TobiasWulf/LED_Cube/README.md

# LED_Cube
Full completed hardware and software project wich I did for EESTEC during my studies at HAW
