TobiasWulf/LED_Cube/Project Outputs for LED_CUBE_5x5x5/Cube_Connector/ReadMe.txt

Hallo Bilex Team,

im RAR-Archiv findet ihr die Gerber files mit der einzelnen Layer.

*.gtl - top-layer
*.gbl - bottom-layer
*.gts - top solder
*.gbs - bottom solder
*.gm1 - mechanical layer 1... etc.
*.gto - top overlay
*.gbo - bottom overlay
*.gko - keep out layer
*.gtp - top paste
*.gbp - bottom paste
*.gpt - top pad master
*.gpb - bottom pad master

die NC Drill files,  leider kann man Layoutprogramm keine excellon files erstellen.

und in dem Ordner CAMtastic eine, *.CAM file, die die gesamte Layerwork und
Drillsection enthält.

Layoutet habe ich mit Altium.

Grüße,

Tobias
