TobiasWulf/LED_Cube/(list of files, cad)

Other CAD files:
Project Outputs for LED_CUBE_5x5x5/Cube_Mainboard/ExportSTEP/Cube_Mainboard.step
Project Outputs for LED_CUBE_5x5x5/Cube_Connector/ExportSTEP/Cube_Connector.step
