TobiasWulf/LED_Cube/Cube.PDF

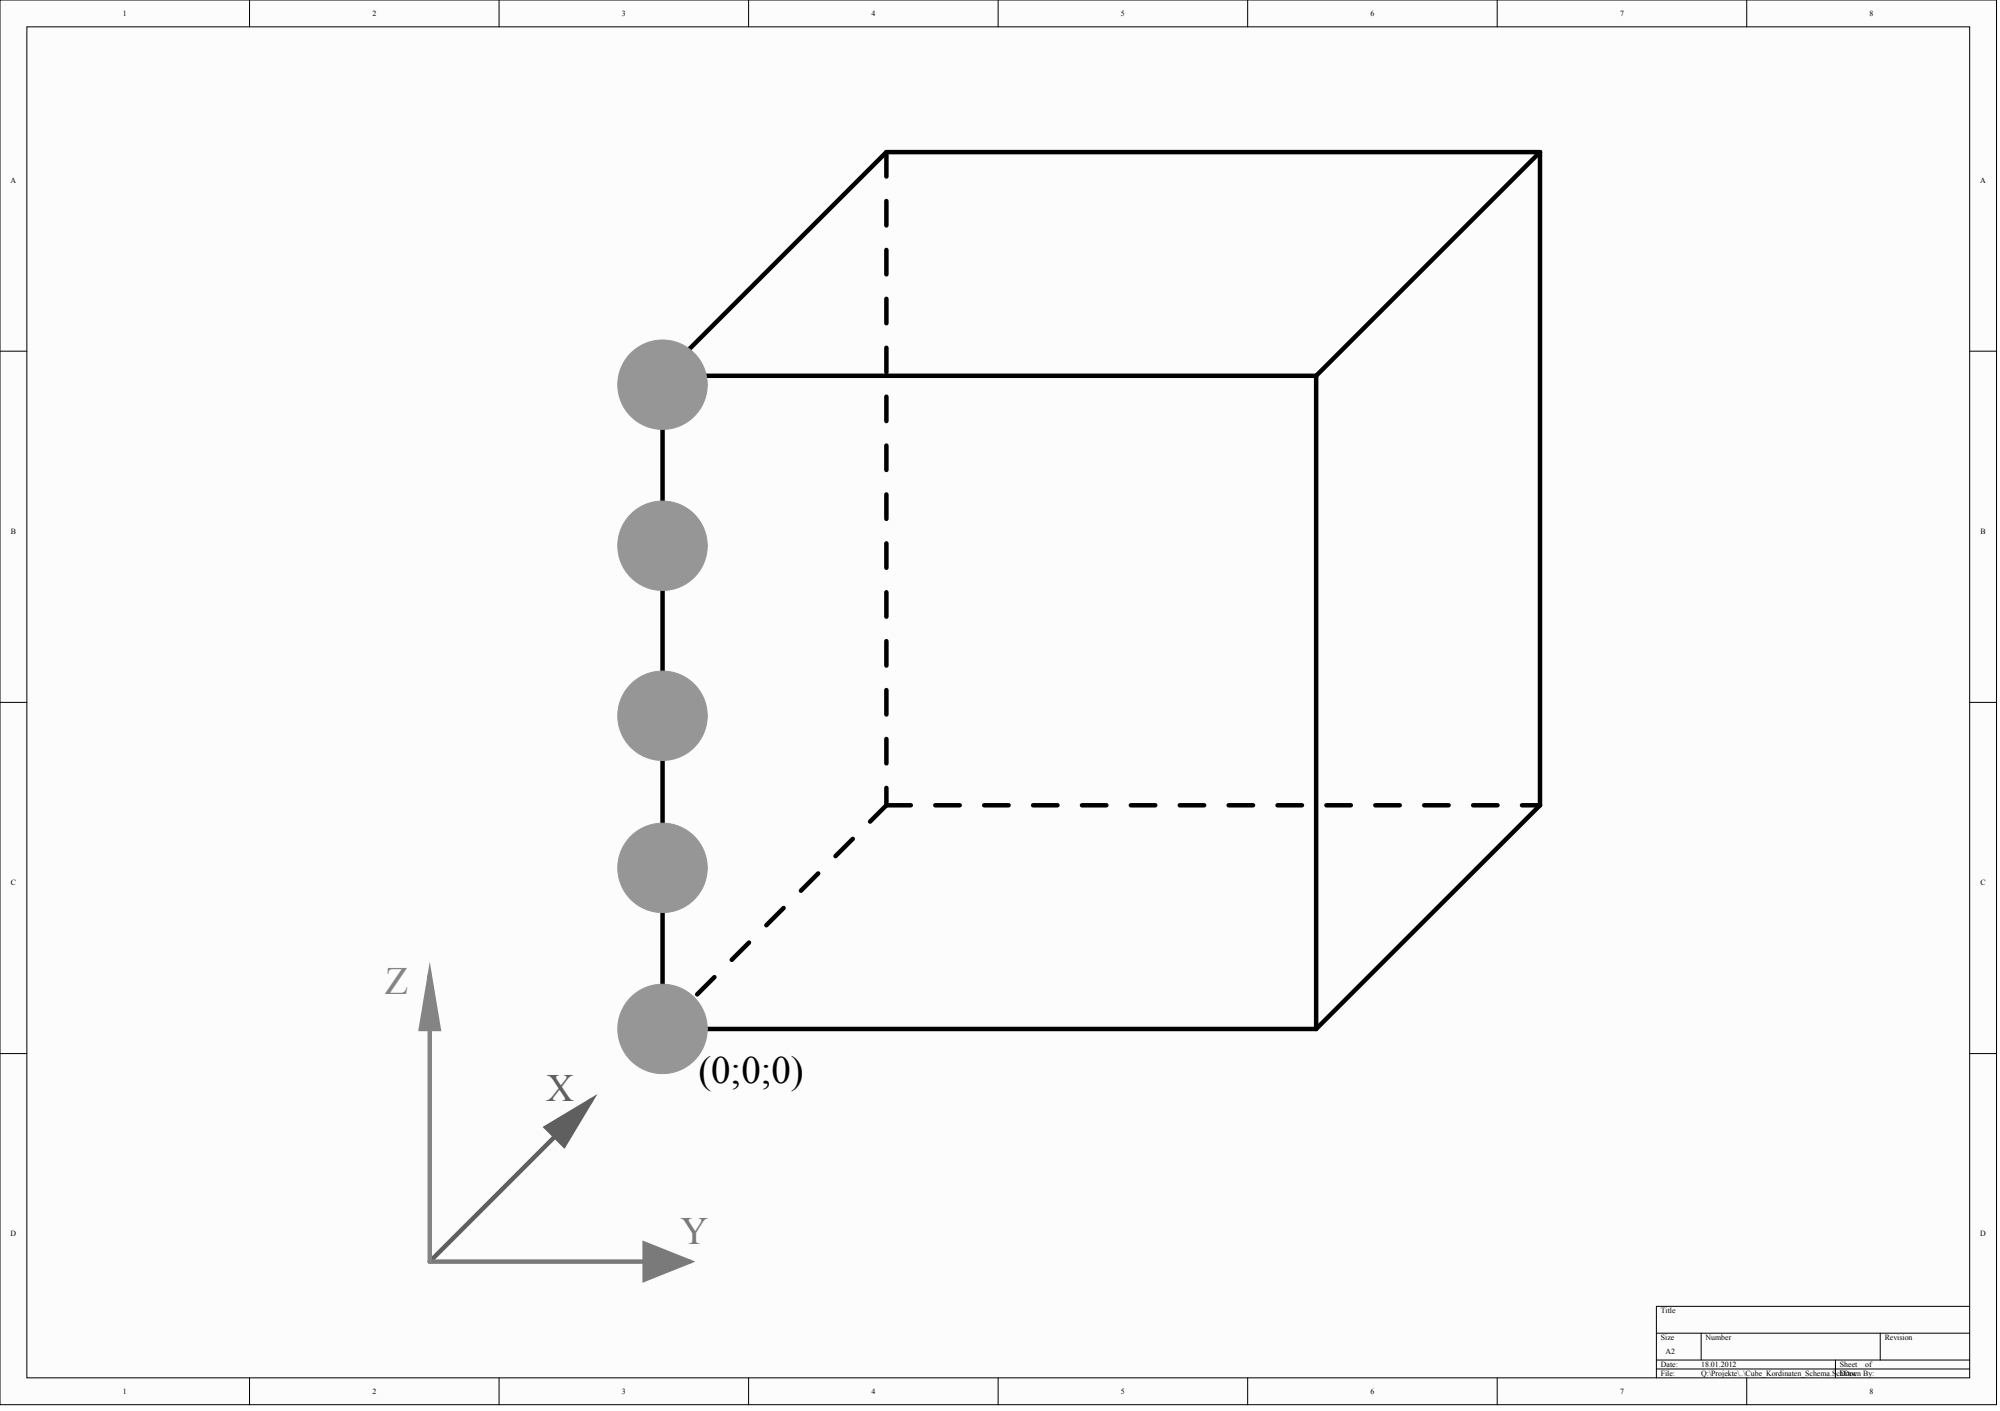
[picture p1: page 1]

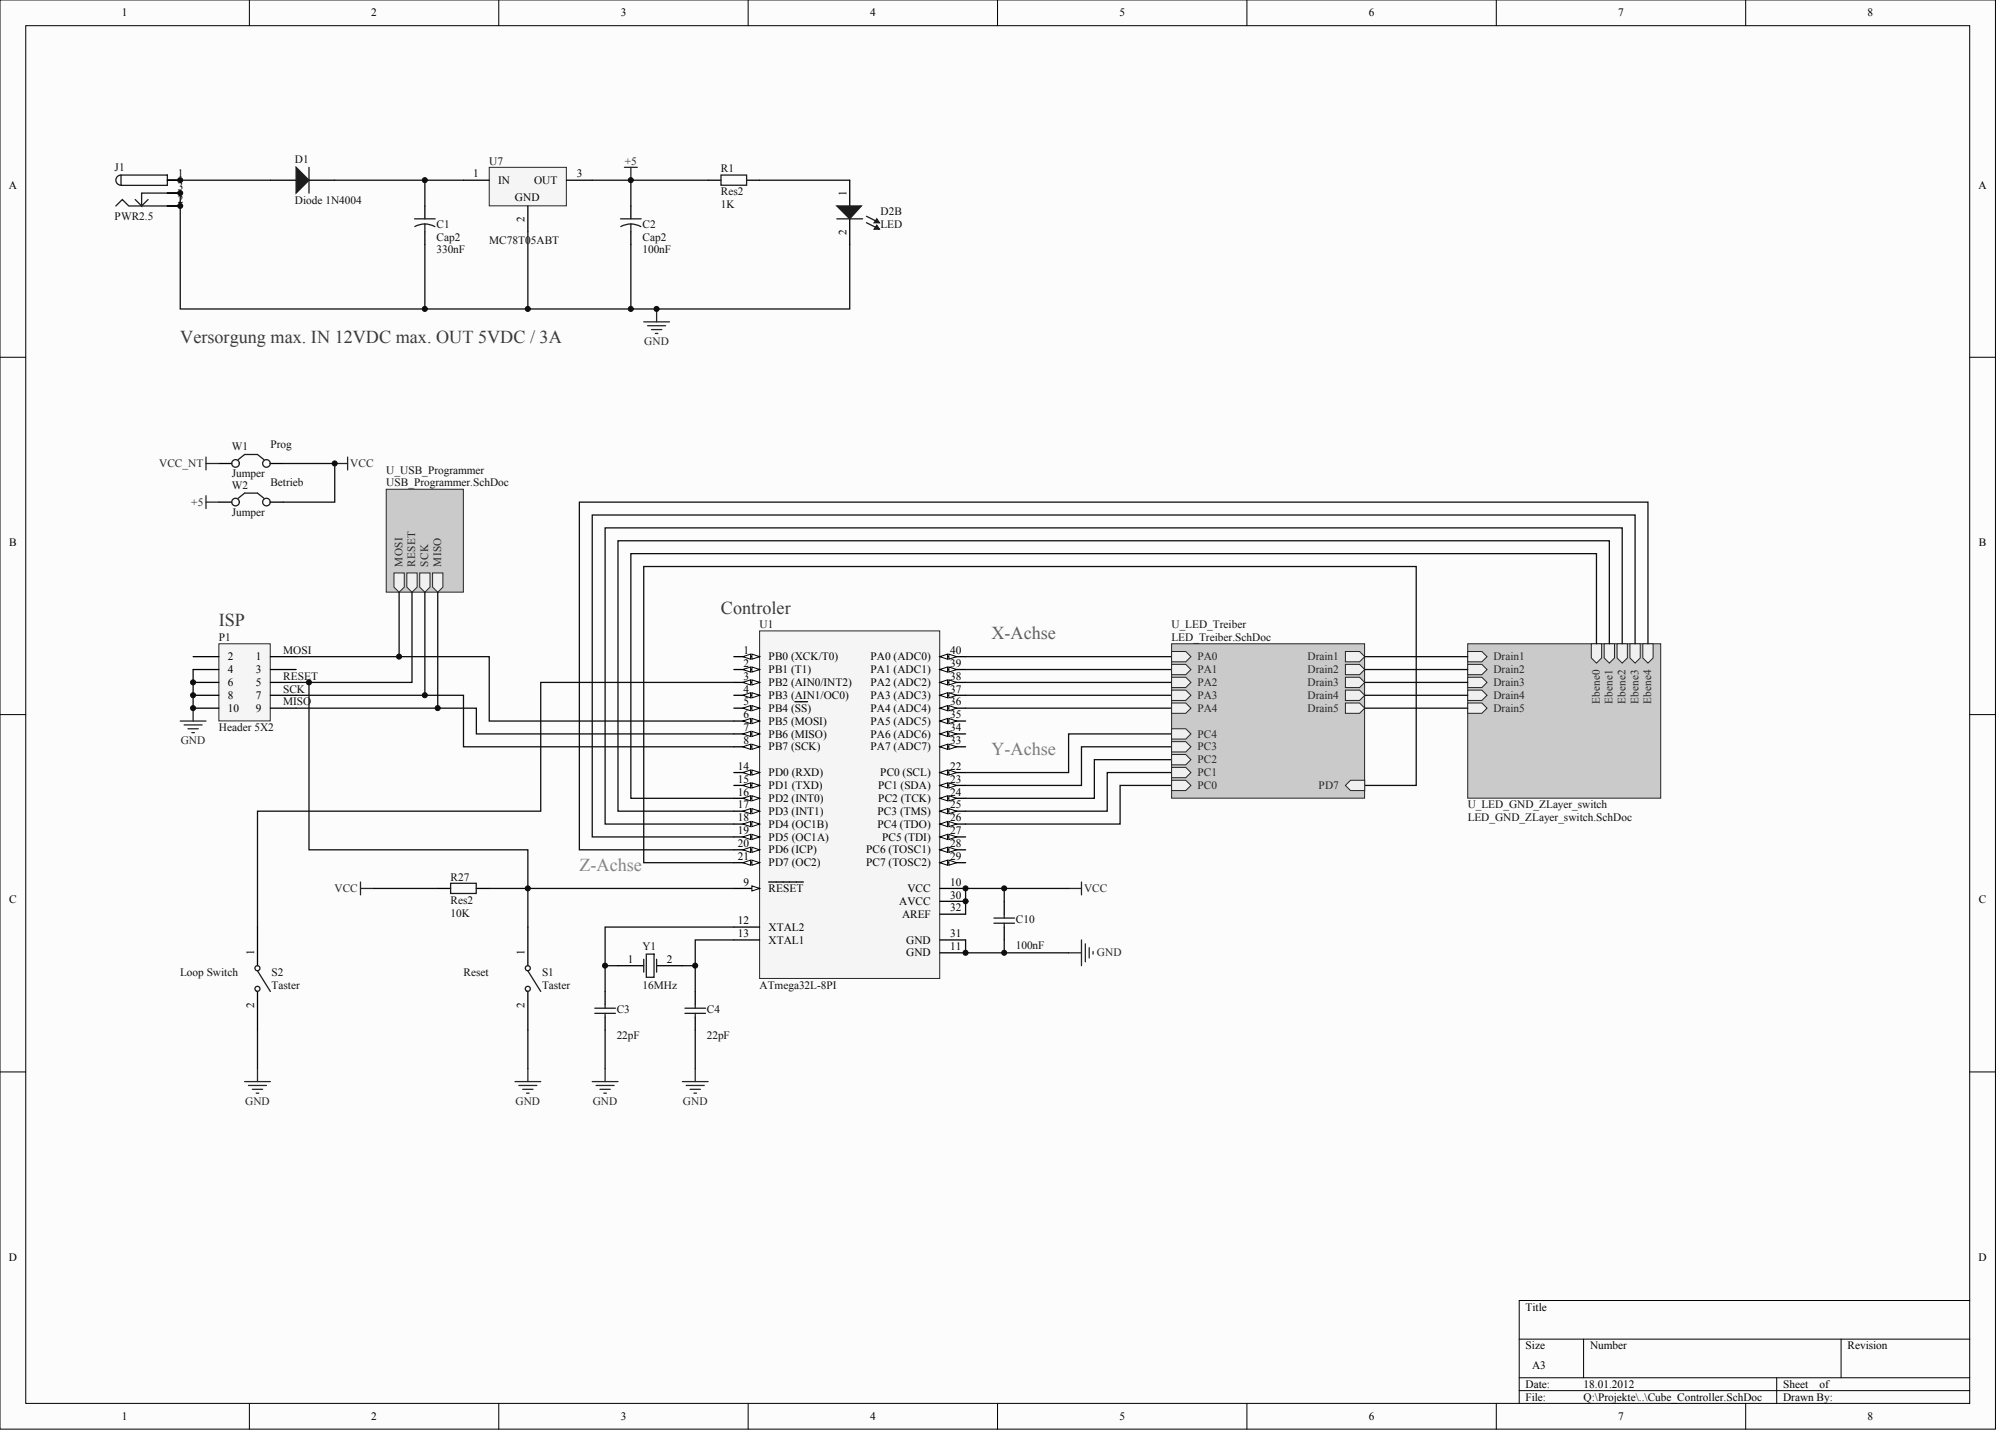
[picture p2: page 2]

Versorgung max. IN 12VDC max. OUT 5VDC / 3A

RESET | | PB1 (T1) 2

SCK | PB3 (AIN1/OC0) 4
MISO | PB4 (SS) 5

PB5 (MOSI) 6

PB7 (SCK) 8

PD3 (INT1) 17 PC3 (TMS) | 25 | U_LED_GND_ZLayer_switch
PD4 (OC1B) 18 | | LED_GND_ZLayer_switch.SchDoc
PD5 (OC1A) 19

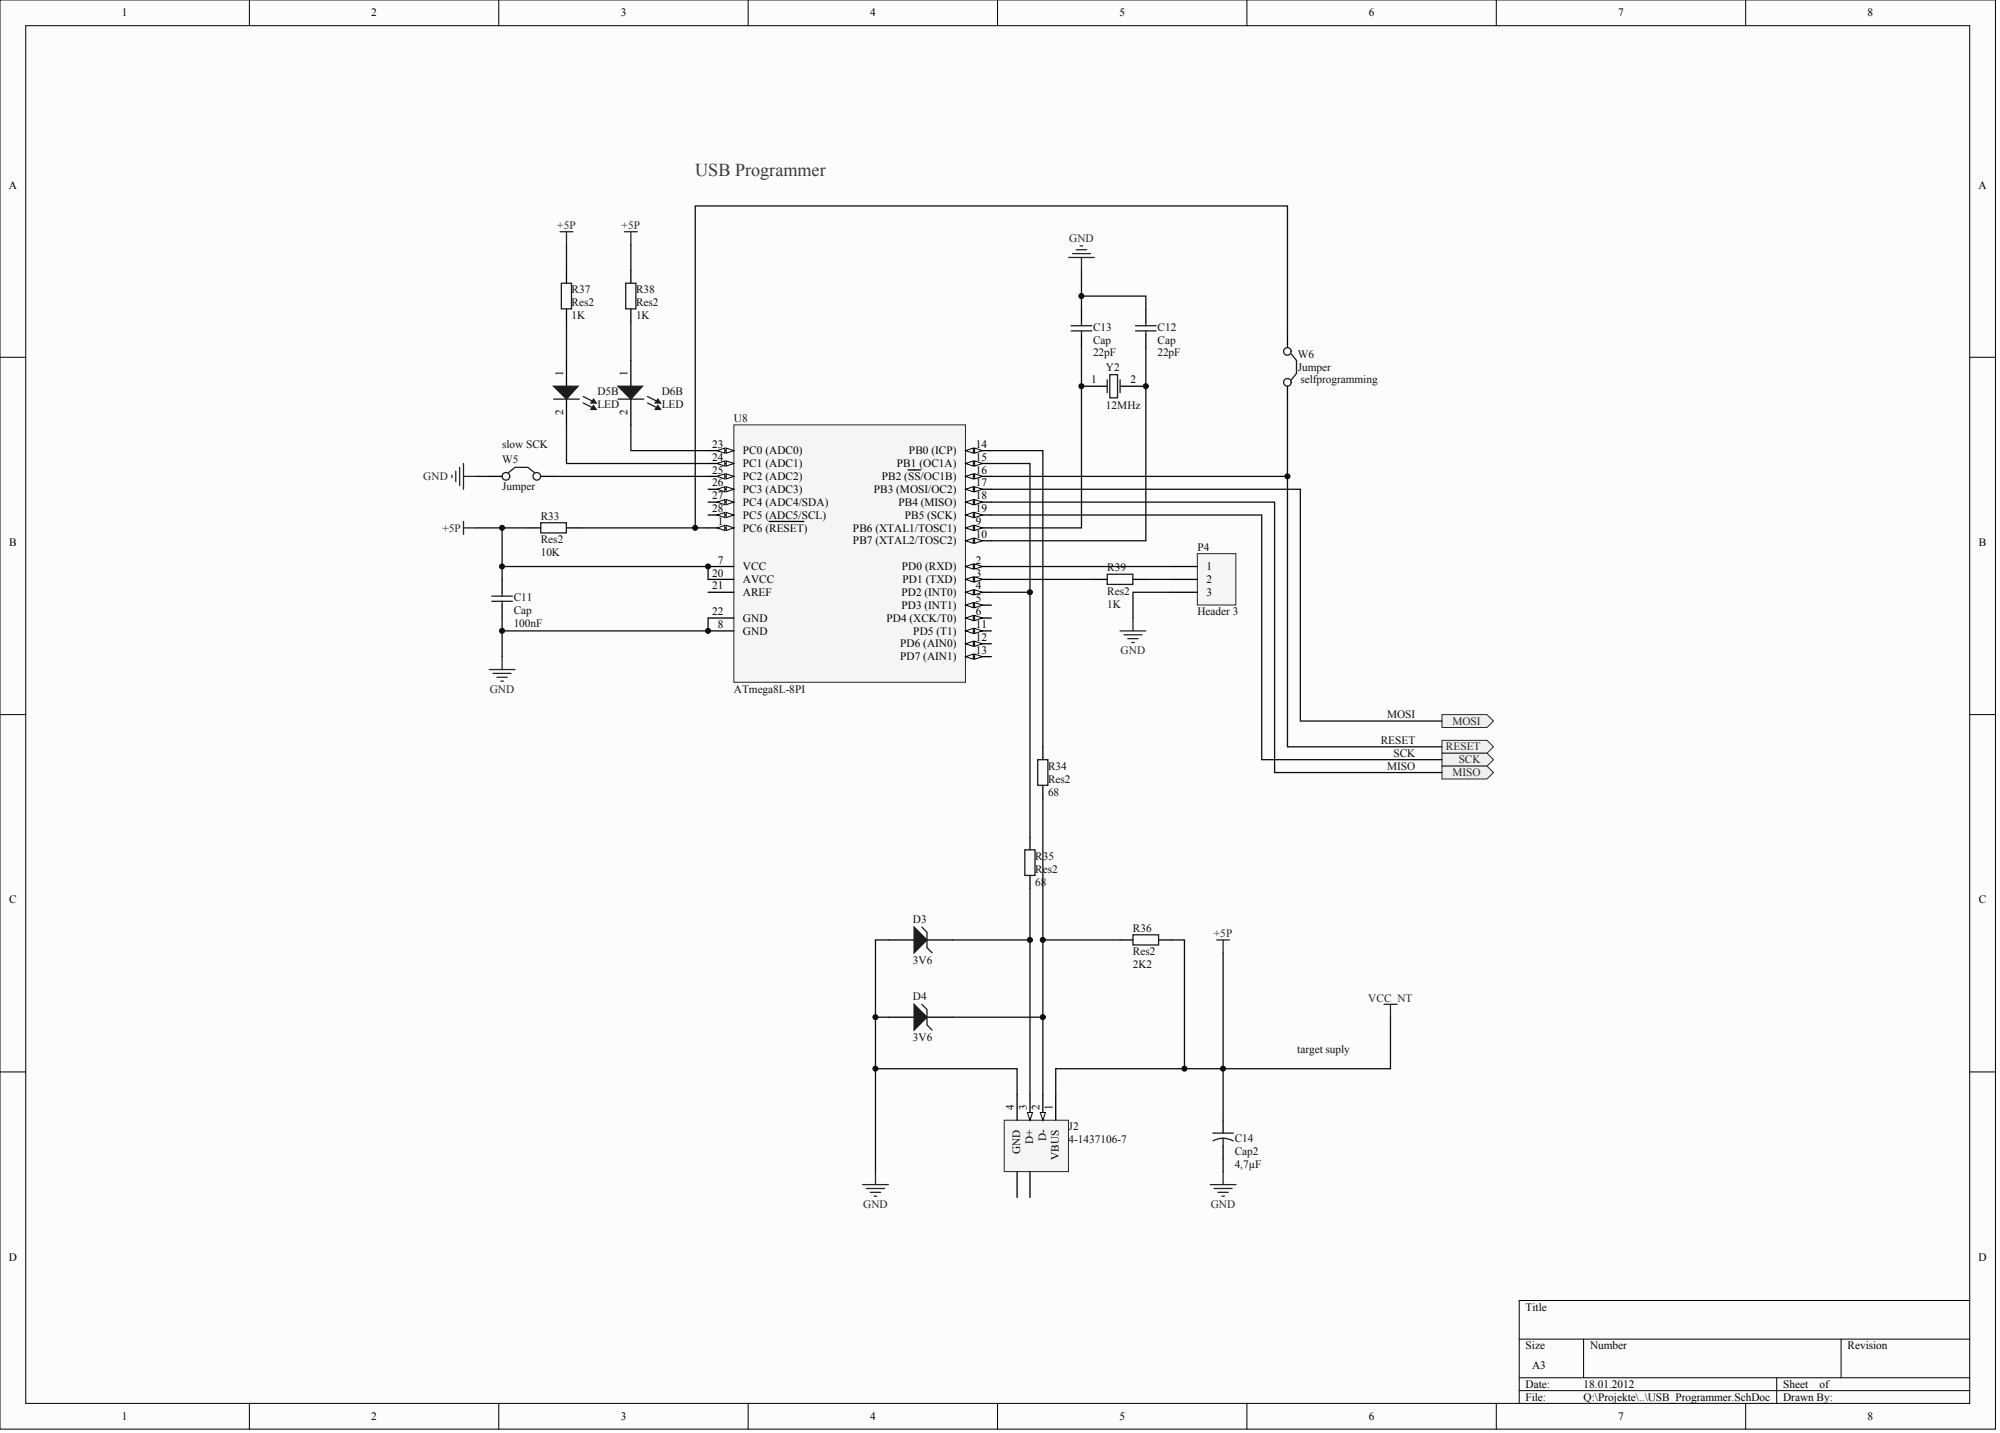
[picture p3: page 3]

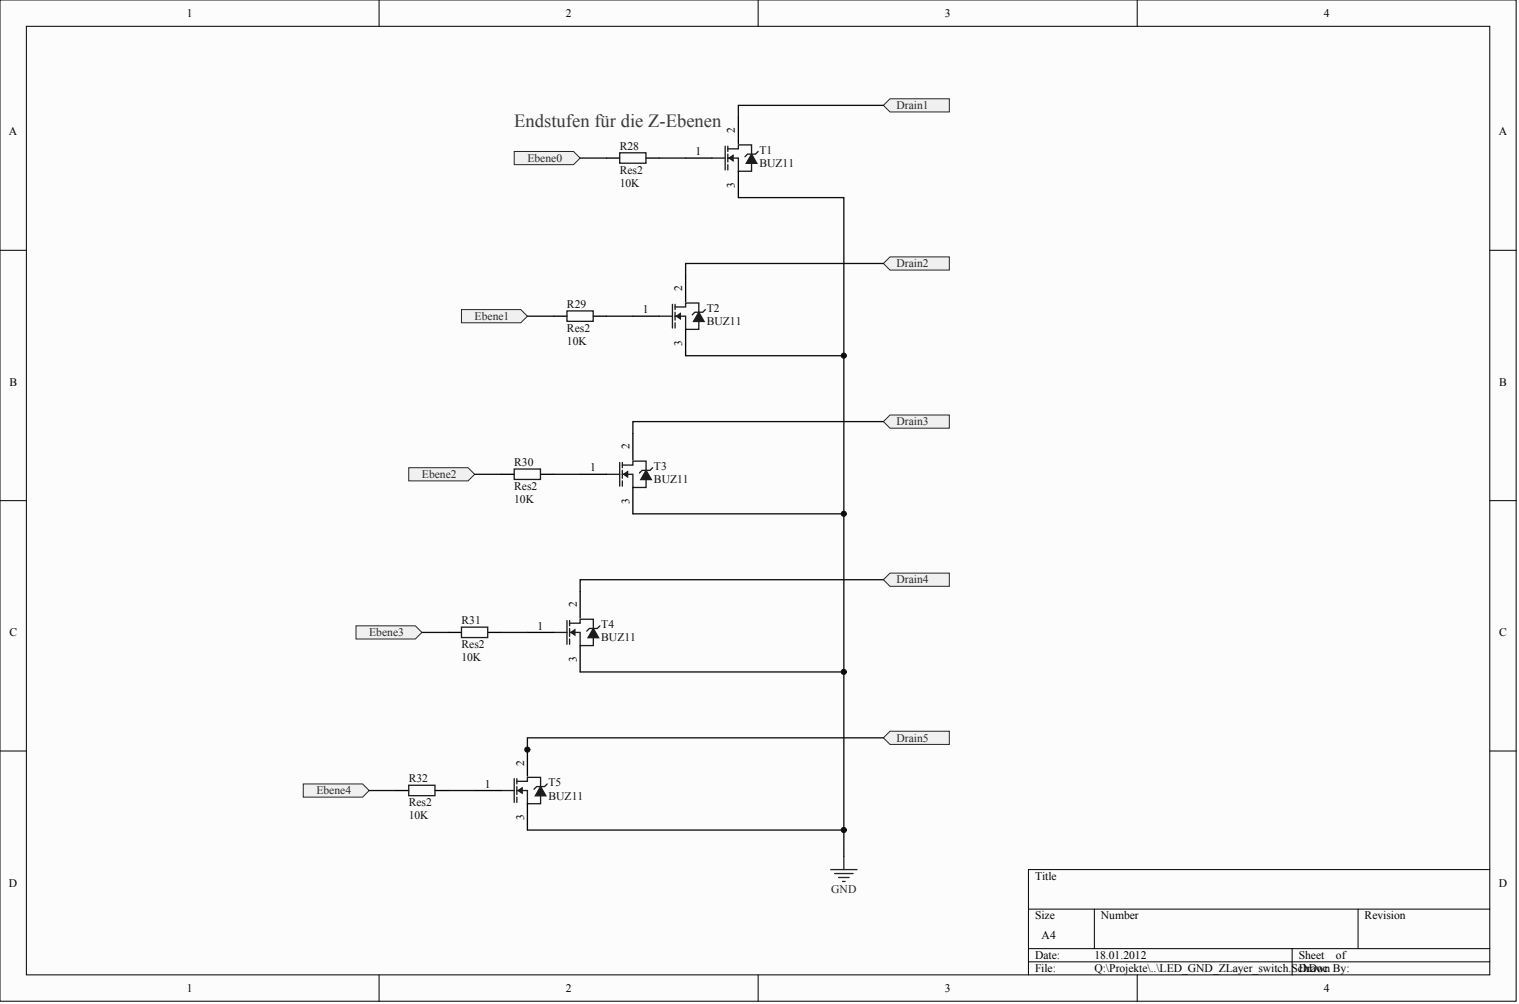
[picture p4: page 4]

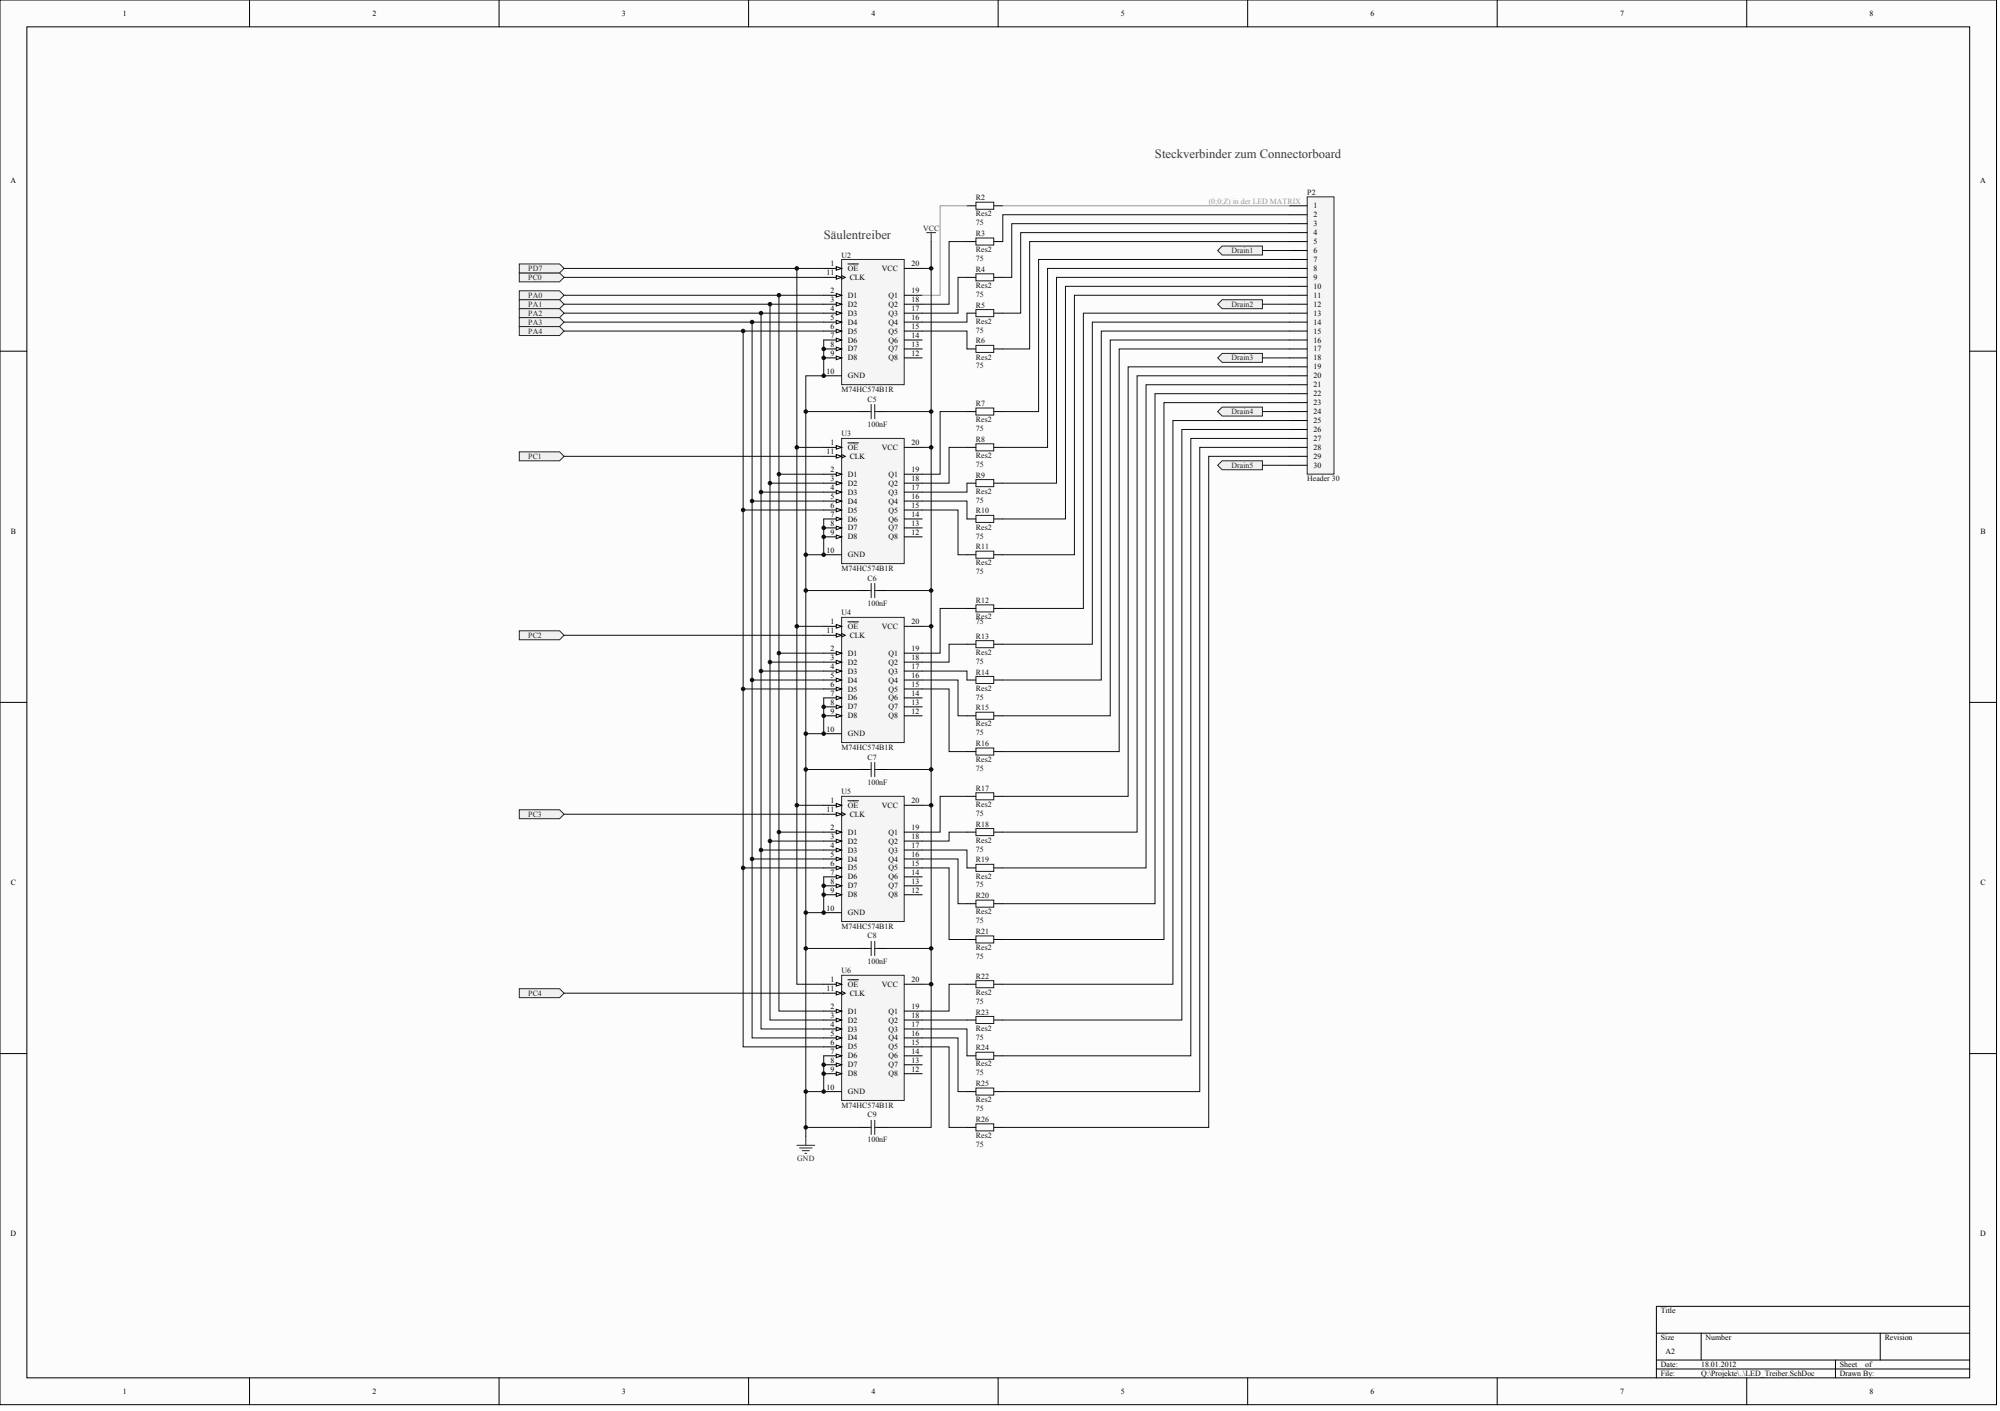
[picture p5: page 5]

(0;0;Z) in der LED MATRI

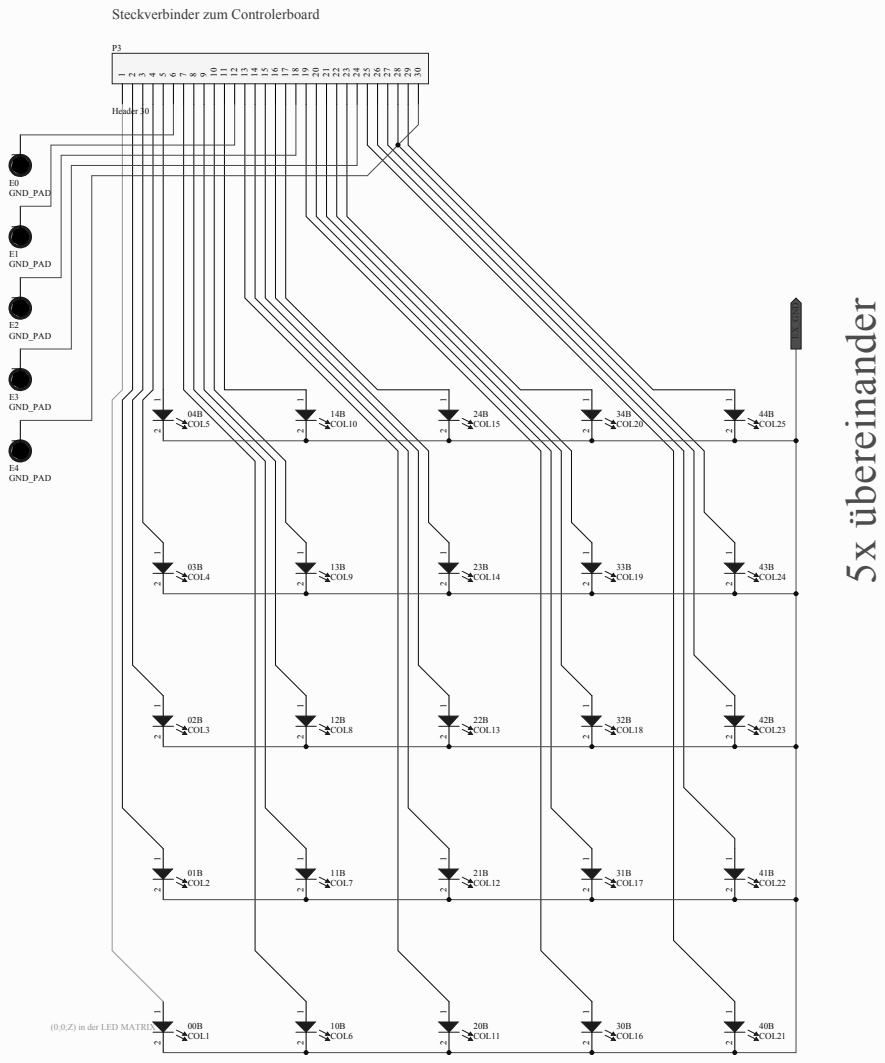
[picture p6: page 6]

(0;0;Z) in der LED MATRI

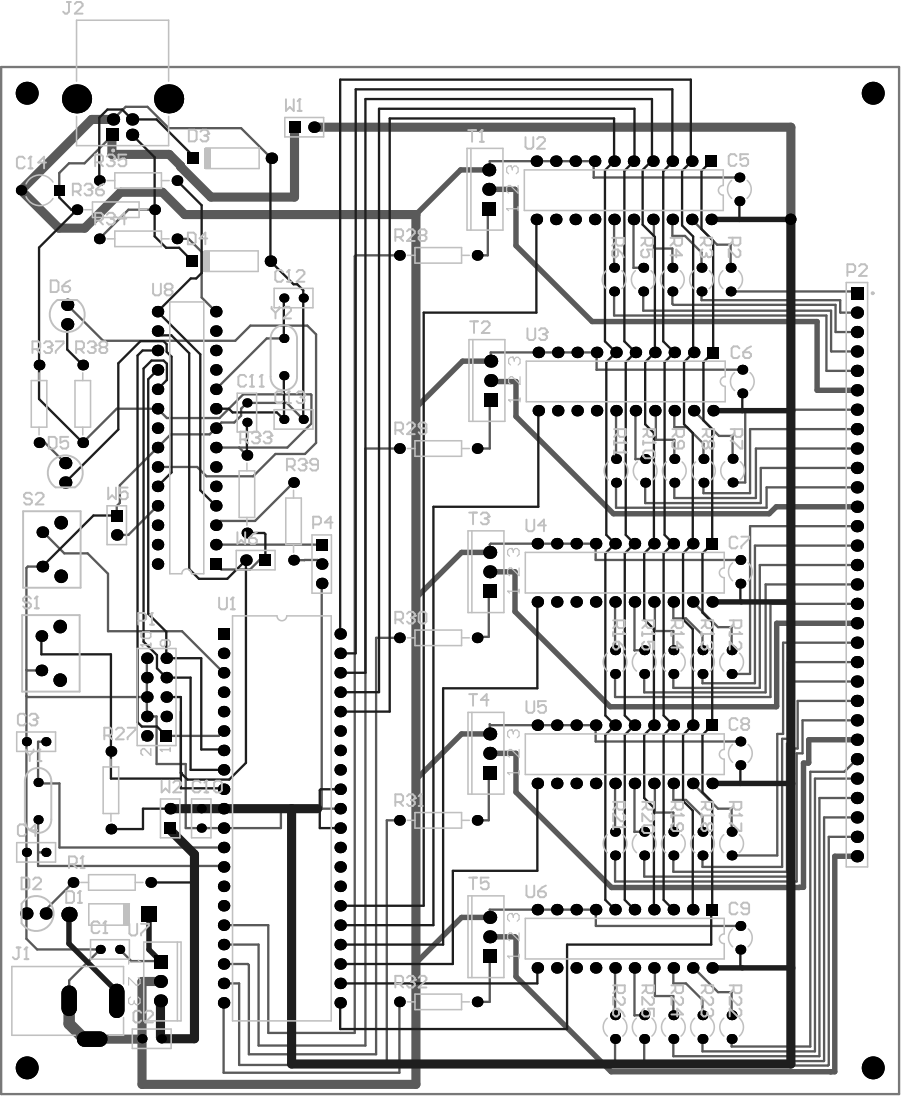
[picture p7: page 7]

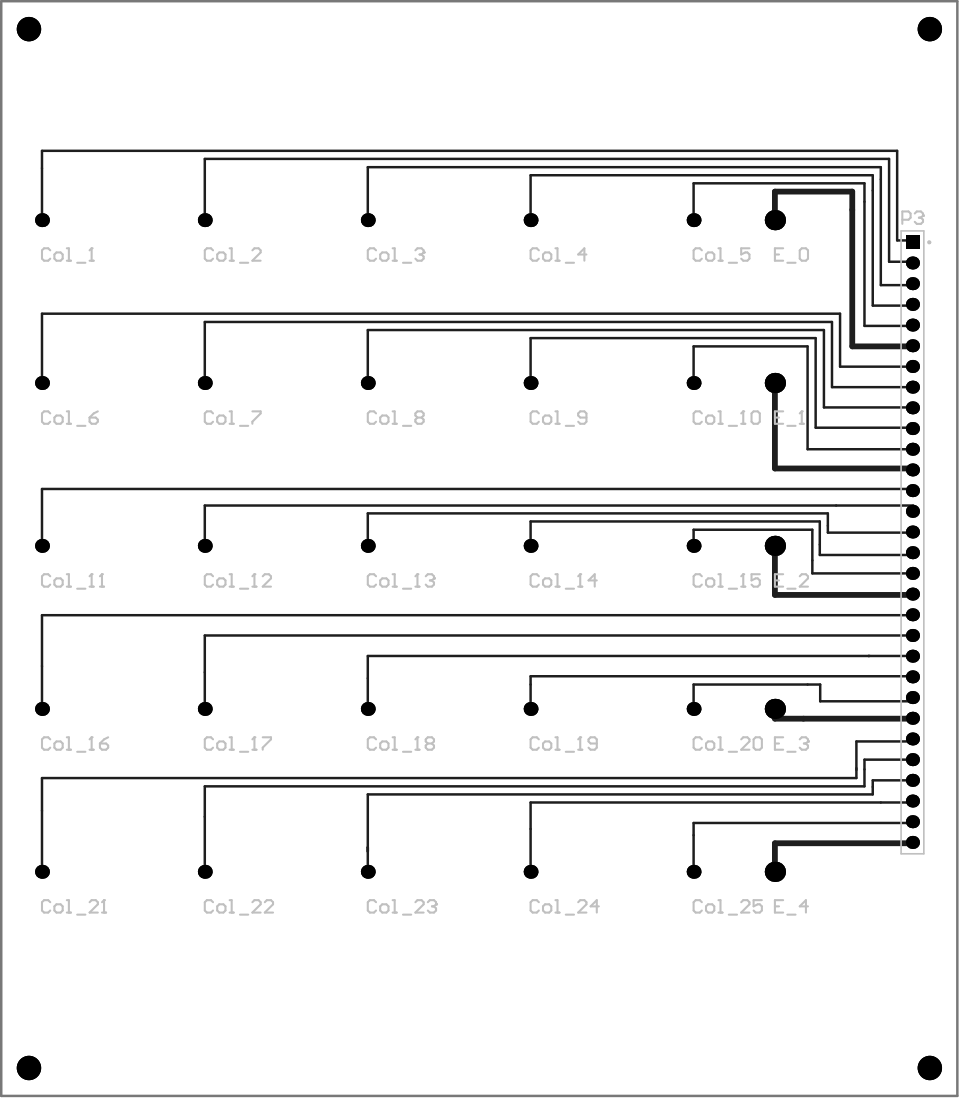
[picture p8: page 8]
