TobiasWulf/LED_Cube/(list of files, drawings)

Other design files:
LED_CUBE_5x5x5.PrjPCB
PCB/Cube_Connector.PcbDoc
PCB/Cube_Mainboard.PcbDoc
Schematics/Cube_Conector.SchDoc
Schematics/Cube_Controller.SchDoc
Schematics/Cube_Kordinaten_Schema.SchDoc
Schematics/LED_GND_ZLayer_switch.SchDoc
Schematics/LED_Treiber.SchDoc
Schematics/main.SchDoc
Schematics/USB_Programmer.SchDoc
