TobiasWulf/LED_Cube/Programming in C/Congress version/animation.c

/*
 *  Project: EesteCube (5x5x5)
 *  animation.c
 *
 *  Created: 17.12.2011 13:58:32
 *  Author: Tobias Wulf
 *  
 *  GPL lisence
 */
  

 #include "cube.h"
 #include <stdlib.h>
 #include <avr/pgmspace.h>

// 6 frame animation of line spinning around the center of the cube
// the animation is in 2 dimensions.
const unsigned char spinning_line[6][5] PROGMEM =
{
	{ 0x10, 0x08, 0x04, 0x02, 0x01 },
	{ 0x00, 0x18, 0x04, 0x03, 0x00 },
	{ 0x00, 0x03, 0x04, 0x18, 0x00 },
	{ 0x01, 0x02, 0x04, 0x08, 0x10 },
	{ 0x02, 0x02, 0x04, 0x08, 0x08 },
	{ 0x08, 0x08, 0x04, 0x02, 0x02 },
};

// Shows an animation of a spinning spiral
void effect_spiral(int direction, int iterations, int delay)
{
	int i;
	int z;		// cube level

	for (i=0;i<iterations;i++)
	{
		// Loop cube levels
		for (z=0;z<5;z++)
		{
			// Read the animation from program memory and put it in the cube buffer.
			// y=0 and y=2 is stored in the upper nibble of the byte, and must be bitshifted into place.
			cube[z][0] = pgm_read_byte(&spinning_line[(i+z)%6][0]);
			cube[z][1] = pgm_read_byte(&spinning_line[(i+z)%6][1]);
			cube[z][2] = pgm_read_byte(&spinning_line[(i+z)%6][2]);
			cube[z][3] = pgm_read_byte(&spinning_line[(i+z)%6][3]);
			cube[z][4] = pgm_read_byte(&spinning_line[(i+z)%6][4]);
			// the +z makes the animation iterate one step for each plane
			// making it into a spiral
		}
		delay_ms(delay);
	}
}

// Shows an animation of a spinning plane.
void effect_spinning_plane(int direction, int iterations, int delay)
{
	int i;
	int z;		// cube level

	for (i=0;i<iterations;i++)
	{
		// Loop cube levels.
		for (z=0;z<5;z++)
		{
			cube[z][0] = pgm_read_byte(&spinning_line[(i)%6][0]);
			cube[z][1] = pgm_read_byte(&spinning_line[(i)%6][1]);
			cube[z][2] = pgm_read_byte(&spinning_line[(i)%6][2]);
			cube[z][3] = pgm_read_byte(&spinning_line[(i)%6][3]);
			cube[z][4] = pgm_read_byte(&spinning_line[(i)%6][4]);
		}
		delay_ms(delay);
	}
}

// Random voxels light up at the top layer and falls to the bottom layer.
void effect_rain (int iterations, int delay, int hold, int speed)
{
	int i;
	int p;		// Position of the raindrop on Z
	int z;		// cube layer
	int y;		// byte
	
	fill(0x00);
	
	for (i = 0; i < iterations; i++)
	{
		// Start by setting a random pixel on layer 4.
		setLED(rand()%5,rand()%5,4);
		delay_ms(hold);
		
		// The raindrop has to step down one layer 5 times
		// in order to travel from the top, and exit out the bottom.
		for (p=1;p<5;p++)
		{
			// Shift all the layers one position down,
			for (z=0;z<4;z++)
			{
				for (y=0;y<5;y++)
				{
					cube[z][y] = cube[z+1][y];
				}
			}
			
			// and a blank image on the top layer.
			cube[4][0] = 0x00;
			cube[4][1] = 0x00;
			cube[4][2] = 0x00;
			cube[4][3] = 0x00;
			cube[4][4] = 0x00;
			
			// Accelerate the raindrop as it falls.
			// (speed/p) will decrease as p increases.
			delay_ms(speed+(speed/p));
		}
		
		fill(0x00);
		delay_ms(delay);
	}
}



// Send a voxel flying from one side of the cube to the other
// It its at the bottom, send it to the top..
void sendvoxel_z (unsigned char x, unsigned char y, unsigned char z, int delay)
{
	int i, ii;
	for (i=0; i<5; i++)
	{
		if (z == 4)
		{
			ii = 4-i;
			clrLED(x,y,ii+1);
		} else
		{
			ii = i;
			clrLED(x,y,ii-1);
		}
		setLED(x,y,ii);
		delay_ms(delay);
	}
}

// Send all the voxels from one side of the cube to the other
// Start at z and send to the opposite side.
// Sends in random order.
void sendplane_rand_z (unsigned char z, int delay, int wait)
{
	unsigned char loop = 25;
	unsigned char x, y;

	fill(0x00);

	setplane_z(z);
	
	// Send voxels at random untill all 16 have crossed the cube.
	while(loop)
	{
		x = rand()%5;
		y = rand()%5;
		if (getLED(x,y,z))
		{
			// Send the voxel flying
			sendvoxel_z(x,y,z,delay);
			delay_ms(wait);
			loop--; // one down, loop-- to go. when this hits 0, the loop exits. 
		}
	}
}

// For each coordinate along X and Y, a voxel is set either at level 0 or at level 3
// for n iterations, a random voxel is sent to the opposite side of where it was.
void sendvoxels_rand_z (int iterations, int delay, int wait)
{
	//unsigned char loop = 25;
	unsigned char x, y, i;
	unsigned char last_x, last_y;

	fill(0x00);

	// Loop through all the X and Y coordinates
	for (x=0;x<5;x++)
	{
		for (y=0;y<5;y++)
		{
			// Then set a voxel either at the top or at the bottom
			if (rand()%2 == 0)
			{
				setLED(x,y,0);
			} else
			{
				setLED(x,y,4);
			}
		}
	}

	for (i=0;i<iterations;i++)
	{
		// Pick a random x,y position
		x = rand()%5;
		y = rand()%5;
		// but not the sameone twice in a row
		if (y != last_y && x != last_x)
		{
			// If the voxel at this x,y is at the bottom
			if (getLED(x,y,0))
			{
				// send it to the top
				sendvoxel_z(x,y,0,delay);
			} else
			{
				// if its at the top, send it to the bottom
				sendvoxel_z(x,y,4,delay);
			}
			delay_ms(wait);
			
			// Remember the last move
			last_y = y;
			last_x = x;
		}
	}

}

// Set n number of voxels at random positions
void random_1 (int iterations, int voxels, int delay)
{
	int i;
	int v;
	for (i = 0; i < iterations; i++)
	{
		for (v=0;v<=voxels;v++)
			setLED(rand()%5,rand()%5,rand()%5);
			
		delay_ms(delay);
		fill(0x00);
	}
}

// blink 1 random voxel, blink 2 random voxels..... blink 20 random voxels
// and back to 1 again.
void random_2 (void)
{
	int i;
	
	for (i=1;i<25;i++)
	{
		random_1(5,i,500);
	}
	
	for (i=25;i>=1;i--)
	{
		random_1(5,i,500);
	}
	
}

// Randomly fill or empty the cube with n voxels.
void random_filler (int iterations, int pixels, int delay, int state)
{
	int i;
	int p;
	for (i = 0; i < iterations; i++)
	{
		for (p=0;p<=pixels;p++)
			alterLED(rand()%5,rand()%5,rand()%5,state);
			
		delay_ms(delay);
	}
}

// Set or clear exactly 125 voxels in a random order.
void random_filler2 (int delay, int state)
{
	int x,y,z;
	int loop = 0;
	
	while (loop<124)
	{
		x = rand()%5;
		y = rand()%5;
		z = rand()%5;

		if ((state == 0 && getLED(x,y,z) == 0x01) || (state == 1 && getLED(x,y,z) == 0x00))
		{
			alterLED(x,y,z,state);
			delay_ms(delay);
			loop++;
		}	
	}
}

// ...to be continiued
void planeflip (unsigned char axis1, int pos1, unsigned char axis2, int pos2, int delay)
{
	
}


// Light all leds layer by layer,
// then unset layer by layer
void loadbar(int delay)
{
	fill(0x00);
	
	int z,y;
	
	for (z=0;z<5;z++)
	{
		for (y=0;y<5;y++)
			cube[z][y] = 0xff;
			
		delay_ms(delay);
	}
	
	delay_ms(delay*3);
	
	for (z=0;z<5;z++)
	{
		for (y=0;y<5;y++)
			cube[z][y] = 0x00;
			
		delay_ms(delay);
	}
}

void flyplane (unsigned char plane,unsigned char direction, int delay)
{
	int i,ii;
	
	fill(0x00);
	
	for (i=0;i<5;i++)
	{
		if (direction != 0)
		{
			ii = 4-i;
		} else
		{
			ii = i;
		}
		
		setplane(plane,ii,1);
		delay_ms(delay);
		setplane(plane,ii,0);
	}
	
	for (i=3;i>=0;i--)
	{
		if (direction != 0)
		{
			ii = 4-i;
		} else
		{
			ii = i;
		}
		
		setplane(plane,ii,1);
		delay_ms(delay);
		setplane(plane,ii,0);
	}
}

void blinky(void)
{
	int a;

	fill(0x00);
	delay_ms(2000);
	
	for (a=0;a<4;a++)
	{
		fill(0x1f);
		delay_ms(50);
		fill(0x00);
		
		delay_ms(1500);
		
		fill(0x1f);
		delay_ms(30);
		fill(0x00);
		
		delay_ms(7000);
	}
	
	
}

void blinky2(void)
{
	int i,r;
	fill(0x00);
	
	for (r=0;r<5;r++)
	{
		i = 750;
		while (i>0)
		{
			fill(0x00);
			delay_ms(i);
			
			fill(0x1f);
			delay_ms(100);
			
			i = i - (15+(1000/(i/10)));
		}
		
		delay_ms(1000);
		
		i = 750;
		while (i>0)
		{
			fill(0x00);
			delay_ms(751-i);
			
			fill(0x1f);
			delay_ms(100);
			
			i = i - (15+(1000/(i/10)));
		}
	}

}

void animateCharacter(char charletter)
{
	int letter = letterToInt(charletter);
	int l=0;
	for(l=0;l<4;l++)
	{
		getLetter(letter,l);
		delay_ms(80);
	}
		getLetter(letter,l);
		delay_ms(500);

	
	
}

void writeBlank(void)
{
		fill(0x00);
		delay_ms(900);

}

void LCHamburg(void)
{
	animateCharacter('E');
	animateCharacter('E');
	animateCharacter('S');
	animateCharacter('T');
	animateCharacter('E');
	animateCharacter('C');
	writeBlank();
	animateCharacter('L');
	animateCharacter('C');
	writeBlank();
	animateCharacter('H');
	animateCharacter('A');
	animateCharacter('M');
	animateCharacter('B');
	animateCharacter('U');
	animateCharacter('R');
	animateCharacter('G');
}

void shiftBack2()
{
int i,j,k;
    for (i=4;i>0;i--)
    {
        for (j=0;j<1;j++)
        {
			for (k=0;k<5;k++)
            {
                if(getLED(i-1,j,k))
                    setLED(i,j,k);
							   //clrLED(i-1,j,k);
                else
                    clrLED(i,j,k);
			}
        }
	}

}

void shiftLeft()
{
int i,j,k;



       for (j=0;j<4;j++)
       {
       for (k=0;k<5;k++)
       {
                       if(getLED(0,j+1,k)){
                            setLED(0,j,k);
							//clrLED(0,j+1,k);
							  }
                       else
                               clrLED(0,j,k);
        }


}
/*for(i=4;i>0;i--)
{
	for (j = 0; j < 5; j++)
		{	
		if(getLED(i-1,0,j)){
			setLED(i,0,j);
			clrLED(i-1,0,j);
		}
		else
			clrLED(i,0,j);
		}
	
}*/
shiftBack2();


delay_ms(150);
}

void writer(char word[],int size)
{
fill(0x00);
	for (unsigned int i = 0; i < (size+3); i++)
{	
	char current = word[i];
	if (i >= size) current = ' ';
	switch(current)
	{case 'A':
	_writeA();
	break;
	case 'B':
	_writeB();
	break;
	case 'C':
	_writeC();
	break;
	case 'D':
	_writeD();
	break;
	case 'E':
	_writeE();
	break;
	case 'F':
	_writeF();
	break;
	case 'G':
	_writeG();
	break;
	case 'H':
	_writeH();
	break;
	case 'I':
	_writeI();
break;
	case 'J':
	_writeJ();
break;
	case 'K':
	_writeK();
break;
	case 'L':
	_writeL();
break;
	case 'M':
	_writeM();
break;
	case 'N':
	_writeN();
break;
	case 'O':
	_writeO();
break;
	case 'P':
	_writeP();
break;
	case 'Q':
	_writeQ();
break;
	case 'R':
	_writeR();
break;
	case 'S':
	_writeS();
break;
	case 'T':
	_writeT();
break;
	case 'U':
	_writeU();
	break;
	case 'V':
	_writeV();
	break;
	case 'W':
	_writeW();
	break;
	case 'X':
	_writeX();
	break;
	case 'Y':
	_writeY();
	break;
	case 'Z':
	_writeZ();
	break;
	case '?':
	_writeQM();
	break;
	case '\'':
	_writeAPO();
	break;
	case '!':
	_writeEM();
	break;
	case '(':
	_writeBRKO();
	break;
	case ')':
	_writeBRKC();
	break;
	case '=':
	_writeEQL();
	break;
	case '.':
	_writeDOT();
	break;
	case ',':
	_writeCOM();
	break;
	default:
	_writeEMP();
	break;
	} 
}
}

void Sejla_Damir()
{
	little_cube();
	
	create_cube(2, 2, 2);
	
	
	
	
	pumping_heart();
	
	//stop()
}

void little_cube(void)
{
	static unsigned int x=0, y=0, z=0;
	unsigned int axis1, direction, iteration;
	
	for (iteration=0; iteration<50; iteration++) {
	
	create_cube(x, y, z);
	
	direction = rand() % 2;

		axis1 = rand() % 3;		
		// if 0 only x changes
		// if 1 only y changes
		// if 2 only z changes
		if(direction==0) 
		{
		if (axis1 == 0)
		{
			if (x+1<4) x++;							
			else x--;
		}
		
		else if (axis1 == 1)
		{
			if (y+1<4) y++;
			else y--;
		}
		
		else if (axis1 == 2)
		{
			if (z+1<4) z++;
			else z--;
		}
		}
		
		else 
		{
		if (axis1 == 0)
		{
			if (x>0) x--;	
			else x++;						
		}
		
		else if (axis1 == 1)
		{
			if (y>0) y--;
			else y++;
		}
		
		else if (axis1 == 2)
		{
			if (z>0) z--;
			else z++;
		}
			
		}	
	
	
	delay_ms(63);
	
	}
}

void create_cube(int x, int y, int z) 
{
	fill(0x00);

	setLED(x, y, z);
	setLED(x ,y, z+1);
	setLED(x, y+1, z);
	setLED(x,y+1,z+1);
	setLED(x+1, y, z);
	setLED(x+1 ,y, z+1);
	setLED(x+1, y+1, z);
	setLED(x+1,y+1,z+1);
}

void pumping_heart() 
{
   int i,j;
   for(i=0;i<7;i++){
	
	fill(0x00);
	
	setLED(2,2,2);
	setLED(2,3,3);
	setLED(2,1,3);
	setLED(2,4,2);
	setLED(2,0,2);
	setLED(2,3,1);
	setLED(2,1,1);
	setLED(2,2,0);
delay_ms(100);

fill(0x00);

	setLED(2,2,2);
	setLED(2,2,0);
	setLED(2,3,3);
	setLED(2,1,3);
	setLED(2+1,4,2);
	setLED(2-1,0,2);
	setLED(2,3,1);
	setLED(2,1,1);
	
delay_ms(100);
	
fill(0x00);

	setLED(2,2,2);
	setLED(2,2,0);
	setLED(2+1,3,3);
	setLED(2-1,1,3);
	setLED(2+2,4,2);
	setLED(2-2,0,2);
	setLED(2+1,3,1);
	setLED(2-1,1,1);
delay_ms(100);
	
fill(0x00);

	setLED(2,2,2);
	setLED(2,2,0);
	setLED(2+1,3,3);
	setLED(2-1,1,3);
	setLED(2+2,4-1,2);
	setLED(2-2,0+1,2);
	setLED(2+1,3,1);
	setLED(2-1,1,1);
	
delay_ms(100);
	
	fill(0x00);

	setLED(2,2,2);
	setLED(2,2,0);
	setLED(2+1,3-1,3);
	setLED(2-1,1+1,3);
	setLED(2+2,4-2,2);
	setLED(2-2,0+2,2);
	setLED(2+1,3-1,1);
	setLED(2-1,1+1,1);
	
delay_ms(100);
	
	
	fill(0x00);

	setLED(2,2,2);
	setLED(2,2,0);
	setLED(2+1,3-1,3);
	setLED(2-1,1+1,3);
	setLED(2+2,4-3,2);
	setLED(2-2,0+3,2);
	setLED(2+1,3-1,1);
	setLED(2-1,1+1,1);
delay_ms(100);
	
	fill(0x00);

	setLED(2,2,2);
	setLED(2,2,0);
	setLED(2+1,3-2,3);
	setLED(2-1,1+2,3);
	setLED(2+2,4-4,2);
	setLED(2-2,0+4,2);
	setLED(2+1,3-2,1);
	setLED(2-1,1+2,1);
	
delay_ms(100);
	
	fill(0x00);

	setLED(2,2,2);
	setLED(2,2,0);
	setLED(2+1,3-2,3);
	setLED(2-1,1+2,3);
	setLED(2+1,4-4,2);
	setLED(2-1,0+4,2);
	setLED(2+1,3-2,1);
	setLED(2-1,1+2,1);
	
	delay_ms(100);
	
	

	}
	
	
	fill(0x00);
	for(j=0;j<5;j++)
	{
	for(i=0;i<3;i++)
	{
	
	setLED(2+i,2,2);
	setLED(2+i,3,3);
	setLED(2+i,1,3);
	setLED(2+i,4,2);
	setLED(2+i,0,2);
	setLED(2+i,3,1);
	setLED(2+i,1,1);
	setLED(2+i,2,0);
	
	setLED(2-i,2,2);
	setLED(2-i,3,3);
	setLED(2-i,1,3);
	setLED(2-i,4,2);
	setLED(2-i,0,2);
	setLED(2-i,3,1);
	setLED(2-i,1,1);
	setLED(2-i,2,0);
	
	
	
delay_ms(100);
}

for(i=2;i>=0;i--)
	{
	
	clrLED(2+i,2,2);
	clrLED(2+i,3,3);
	clrLED(2+i,1,3);
	clrLED(2+i,4,2);
	clrLED(2+i,0,2);
	clrLED(2+i,3,1);
	clrLED(2+i,1,1);
	clrLED(2+i,2,0);
	
	clrLED(2-i,2,2);
	clrLED(2-i,3,3);
	clrLED(2-i,1,3);
	clrLED(2-i,4,2);
	clrLED(2-i,0,2);
	clrLED(2-i,3,1);
	clrLED(2-i,1,1);
	clrLED(2-i,2,0);
	
	
	
delay_ms(100);
}
}	
}

void effect_everything_bitches(int direction, int iterations, int delay)
{
	int i;

	for(i=0;i<4;i++)	
		effect_rings(1,10,0);
	for(i=0;i<4;i++)	
		effect_explosion(1,10,0);
	for(i=0;i<16;i++)		
		effect_snow(1,10,385);
	for(i=0;i<64;i++)		
		effect_blink(1,10,10);
	for(i=0;i<128;i++)	
		effect_noise(1,10,10);
		
}

void effect_rings(int direction, int iterations, int delay)
{
	char Array[5][5][5];

	int i,j,k,rand;
	for (i=0;i<5;i++)
		for (j=0;j<5;j++)
			for (k=0;k<5;k++)
				{
					Array[i][j][k]=0;
				}
				
	grow2(Array,delay);

}

				
void effect_explosion(int direction, int iterations, int delay)
{
	char Array[5][5][5];

	int i,j,k,rand;
	for (i=0;i<5;i++)
		for (j=0;j<5;j++)
			for (k=0;k<5;k++)
				{
					Array[i][j][k]=0;
				}
				
	grow(Array,delay);

	
	for (i=0;i<5;i++)
		for (j=0;j<5;j++)
			for (k=0;k<5;k++)
				{
				rand=random()%3;
				if(rand==0)
					Array[i][j][k]=1;
				else
					Array[i][j][k]=0;
				}

	
	shrink(Array,delay);
	grow(Array,delay);
	
		
	for (i=0;i<5;i++)
		for (j=0;j<5;j++)
			for (k=0;k<5;k++)
				{
					Array[i][j][k]=0;
				}
				
	shrink(Array,delay);


}

void grow(char Array[5][5][5], int delay)
{
	double a,r=0;
	int i,j,k;

	for(a=0;a<45;a++)
	{
	for (i=0;i<5;i++)
	{
	for (j=0;j<5;j++)
	{
	for (k=0;k<5;k++)
		{
		if(sqrt((i-2)*(i-2)+(j-2)*(j-2)+(k-2)*(k-2))<r)
			setLED(i,j,k);
		else
			if(Array[i][j][k]==1)
				setLED(i,j,k);
			else
				clrLED(i,j,k);
		}
	}
	}
	r=a/10;
	delay_ms(delay);
	}
}

void grow2(char Array[5][5][5], int delay)
{
	double a,r=0;
	int i,j,k;

	for(a=4;a<36;a++)
	{
		for (i=0;i<5;i++)
		{
			for (j=0;j<5;j++)
			{
			for (k=0;k<5;k++)
				{
				if(sqrt((i-2)*(i-2)+(j-2)*(j-2)+(k-2)*(k-2))<r)
					setLED(i,j,k);
				/*else
					if(Array[i][j][k]==1)
						setLED(i,j,k);*/
					else
						clrLED(i,j,k);
				if(sqrt((i-2)*(i-2)+(j-2)*(j-2)+(k-2)*(k-2))<r-0.7)
					clrLED(i,j,k);
				
				}
			}
		}
	r=a/10;
	delay_ms(delay);
	}
}

void shrink(char Array[5][5][5], int delay)
{
	double a,r=0;
	int i,j,k;
	for(a=45;a>=0;a--)
	{
	r=a/10;
	for (i=0;i<5;i++)
	{
	for (j=0;j<5;j++)
	{
	for (k=0;k<5;k++)
		{
		if(sqrt((i-2)*(i-2)+(j-2)*(j-2)+(k-2)*(k-2))<r)
			setLED(i,j,k);
		else
			if(Array[i][j][k]==1)
				setLED(i,j,k);
			else
				clrLED(i,j,k);
		}
	}
	}
	delay_ms(delay);
	}	

}


int bla=0;
int up=1;
void effect_blink(int direction, int iterations, int delay)
{
	dim(bla);
	if(up==1) 
		{
		bla++;
		if(bla==9) up=0;
		}
	if(up==0) 
		{
		bla--;
		if(bla==0) up=1;
		}
}

void dim(int intensity){
for(int i=0;i<10;i++){
	intensity = intensity%10;
	fill(0x1f);
	delay_ms(intensity);
	fill(0x00);
	delay_ms(10-intensity);
	}
}

void effect_snow(int direction, int iterations, int delay)
{
	int i,j,k;
	int a;
	
	for (i=0;i<5;i++)
	{
	for (j=0;j<5;j++)
	{
	for (k=0;k<4;k++)
		{
			if(getLED(i,j,k+1))
				setLED(i,j,k);
			else
				clrLED(i,j,k);
		}
	}
	
	}
		for (i=0;i<5;i++)
		for (j=0;j<5;j++){
				a=random()%8;
				if(a==0)
					setLED(i,j,4);
				else
					clrLED(i,j,4);
				}
	delay_ms(delay);	
}

void effect_noise(int direction, int iterations, int delay)
{
		int i,j,k;
		int a;
	for (i=0;i<5;i++)
	{
	for (j=0;j<5;j++)
	{
	for (k=0;k<5;k++)
		{
		
		a=random()%2;
		if(a)
			setLED(i,j,k);
		else
			clrLED(i,j,k);
		}
	}
	}	
}

void effect_wasdf3(int direction, int iterations, int delay)
{
		int i,j,k;
		int a;
	for (i=0;i<5;i++)
	{
	for (j=0;j<5;j++)
	{
	for (k=0;k<5;k++)
		{
		a=random()%2;
		if(a)
			setLED(i,j,k);
		}
	}
	}
	delay_ms(1000);
	fill(0x00);

	
}

void effect_wasdf2(int direction, int iterations, int delay)
{
	int i,j,k;
	for (i=0;i<5;i++)
	{
	for (j=0;j<5;j++)
	{
	for (k=0;k<5;k++)
		{
		setLED(i,j,k);
		delay_ms(20);
		fill(0x00);
		}
	}
	}
	
	/*fill(0x1f);
	delay_ms(10);
	fill(0x00);
	delay_ms(10);*/

	
}
