TobiasWulf/LED_Cube/Programming in C/History/Ariane&Ivica/animation.c

/*
 *  Project: EesteCube (5x5x5)
 *  animation.c
 *
 *  Created: 17.12.2011 13:58:32
 *  Author: Tobias Wulf & Ariane Raschke
 *  
 *  GPL lisence
 */
  

 #include "cube.h"
 #include <stdlib.h>
 #include <avr/pgmspace.h>

// 6 frame animation of line spinning around the center of the cube
// the animation is in 2 dimensions.
const unsigned char spinning_line[6][5] PROGMEM =
{
	{ 0x10, 0x08, 0x04, 0x02, 0x01 },
	{ 0x00, 0x18, 0x04, 0x03, 0x00 },
	{ 0x00, 0x03, 0x04, 0x18, 0x00 },
	{ 0x01, 0x02, 0x04, 0x08, 0x10 },
	{ 0x02, 0x02, 0x04, 0x08, 0x08 },
	{ 0x08, 0x08, 0x04, 0x02, 0x02 },
};

// Shows an animation of a spinning spiral
void effect_spiral(int direction, int iterations, int delay)
{
	int i;
	int z;		// cube level

	for (i=0;i<iterations;i++)
	{
		// Loop cube levels
		for (z=0;z<5;z++)
		{
			// Read the animation from program memory and put it in the cube buffer.
			// y=0 and y=2 is stored in the upper nibble of the byte, and must be bitshifted into place.
			cube[z][0] = pgm_read_byte(&spinning_line[(i+z)%6][0]);
			cube[z][1] = pgm_read_byte(&spinning_line[(i+z)%6][1]);
			cube[z][2] = pgm_read_byte(&spinning_line[(i+z)%6][2]);
			cube[z][3] = pgm_read_byte(&spinning_line[(i+z)%6][3]);
			cube[z][4] = pgm_read_byte(&spinning_line[(i+z)%6][4]);
			// the +z makes the animation iterate one step for each plane
			// making it into a spiral
		}
		delay_ms(delay);
	}
}

// Shows an animation of a spinning plane.
void effect_spinning_plane(int direction, int iterations, int delay)
{
	int i;
	int z;		// cube level

	for (i=0;i<iterations;i++)
	{
		// Loop cube levels.
		for (z=0;z<5;z++)
		{
			cube[z][0] = pgm_read_byte(&spinning_line[(i)%6][0]);
			cube[z][1] = pgm_read_byte(&spinning_line[(i)%6][1]);
			cube[z][2] = pgm_read_byte(&spinning_line[(i)%6][2]);
			cube[z][3] = pgm_read_byte(&spinning_line[(i)%6][3]);
			cube[z][4] = pgm_read_byte(&spinning_line[(i)%6][4]);
		}
		delay_ms(delay);
	}
}


void shiftBack()
{
int i,j,k;
       for (i=4;i>0;i--)
       {
       for (j=0;j<5;j++)
       {
       for (k=0;k<5;k++)
               {
                       if(getLED(i-1,j,k)){
                               setLED(i,j,k);
							   //clrLED(i-1,j,k);
							   }
                       else
                               clrLED(i,j,k);
               }
       }
}
}

void shiftBack2()
{
int i,j,k;
    for (i=4;i>0;i--)
    {
        for (j=0;j<1;j++)
        {
			for (k=0;k<5;k++)
            {
                if(getLED(i-1,j,k))
                    setLED(i,j,k);
							   //clrLED(i-1,j,k);
                else
                    clrLED(i,j,k);
			}
        }
	}

}

void shiftLeft()
{
int i,j,k;



       for (j=0;j<4;j++)
       {
       for (k=0;k<5;k++)
       {
                       if(getLED(0,j+1,k)){
                            setLED(0,j,k);
							//clrLED(0,j+1,k);
							  }
                       else
                               clrLED(0,j,k);
        }


}
/*for(i=4;i>0;i--)
{
	for (j = 0; j < 5; j++)
		{	
		if(getLED(i-1,0,j)){
			setLED(i,0,j);
			clrLED(i-1,0,j);
		}
		else
			clrLED(i,0,j);
		}
	
}*/
shiftBack2();


delay_ms(150);
}


void effect_EESTEC()
{
	fill(0);	// E
	delay_ms(70);
	line_z(0, 0, 0, 4, 1);	
	line_y(0, 0, 0, 4, 1);
	line_y(2, 0, 0, 4, 1);
	line_y(4, 0, 0, 4, 1);
	delay_ms(250);
	
	
	fill(0);	// E  
	delay_ms(70);
	line_z(0, 0, 0, 4, 1);	
	line_y(0, 0, 0, 4, 1);
	line_y(2, 0, 0, 4, 1);
	line_y(4, 0, 0, 4, 1);
	delay_ms(250);
	
	fill(0);     // S
	delay_ms(70);
	setLED(0, 0, 3);	
	setLED(0, 4, 1);	
	line_y(0, 0, 0, 4, 1);
	line_y(2, 0, 0, 4, 1);
	line_y(4, 0, 0, 4, 1);
	clrLED(0,4,0);
	clrLED(0,0,4);
	delay_ms(250);
	
	fill(0);	// T
	delay_ms(70);
	line_y(4, 0, 0, 4, 1);
	line_z(0, 2, 0, 4, 1);
	delay_ms(250);
		
	fill(0);	// E
	delay_ms(70);
	line_z(0, 0, 0, 4, 1);	
	line_y(0, 0, 0, 4, 1);
	line_y(2, 0, 0, 4, 1);
	line_y(4, 0, 0, 4, 1);
	delay_ms(250);
	
	fill(0);	// C
	delay_ms(70);
	line_z(0, 0, 0, 4, 1);	
	line_y(0, 0, 0, 4, 1);
	line_y(4, 0, 0, 4, 1);
	delay_ms(250);
	
	fill(0);	// W
	delay_ms(270);
	line_z(0, 0, 0, 4, 1);	
	line_z(0, 4, 0, 4, 1);
	setLED(0, 1, 1);
	setLED(0, 2, 2);
	setLED(0, 3, 1);
	delay_ms(250); 
	
	fill(0);	// H
	delay_ms(70);  
	line_z(0, 0, 0, 4, 1);	
	line_z(0, 4, 0, 4, 1);
	line_y(2, 0, 0, 4, 1);	
	delay_ms(250);
	
	fill(0);	// A
	delay_ms(70);  
	line_z(0, 0, 0, 4, 1);	
	line_z(0, 4, 0, 4, 1);
	line_y(2, 0, 0, 4, 1);	
	line_y(4, 0, 0, 4, 1);	
	clrLED(0, 0, 4);
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
setLine(0,1,1,1,0);
setLine(0,0,0,0,0);
}


void writeR()
{
setLine(1,1,1,1,1);
setLine(1,0,1,0,0);
setLine(1,0,1,1,0);
setLine(0,1,0,0,1);
setLine(0,0,0,0,0);
}

void writeS()
{
setLine(0,1,0,0,1);
setLine(1,0,1,0,1);
setLine(1,0,1,0,1);
setLine(1,0,0,1,0);
setLine(0,0,0,0,0);

}

void writeT()
{
setLine(1,0,0,0,0);
setLine(1,0,0,0,0);
setLine(1,1,1,1,1);
setLine(1,0,0,0,0);
setLine(1,0,0,0,0);
setLine(0,0,0,0,0);

}


void writeU()
{
setLine(1,1,1,1,0);
setLine(0,0,0,0,1);
setLine(0,0,0,0,1);
setLine(1,1,1,1,0);
setLine(0,0,0,0,0);
}

void writeV()
{
setLine(1,1,1,0,0);
setLine(0,0,0,1,0);
setLine(0,0,0,0,1);
setLine(0,0,0,1,0);
setLine(1,1,1,0,0);
setLine(0,0,0,0,0);
}

void writeW()
{
setLine(1,1,1,1,1);
setLine(0,0,0,1,0);
setLine(0,0,1,0,0);
setLine(0,0,0,1,0);
setLine(1,1,1,1,1);
setLine(0,0,0,0,0);
}

void writeX()
{
setLine(1,0,0,0,1);
setLine(0,1,0,1,0);
setLine(0,0,1,0,0);
setLine(0,1,0,1,0);
setLine(1,0,0,0,1);
setLine(0,0,0,0,0);
}

void writeY()
{
setLine(1,0,0,0,0);
setLine(0,1,0,0,0);
setLine(0,0,1,1,1);
setLine(0,1,0,0,0);
setLine(1,0,0,0,0);
setLine(0,0,0,0,0);
}

void writeZ()
{
setLine(1,0,0,0,1);
setLine(1,0,0,1,1);
setLine(1,0,1,0,1);
setLine(1,1,0,0,1);
setLine(1,0,0,0,1);
setLine(0,0,0,0,0);
}

void writeQM()
{
setLine(0,1,0,0,0);
setLine(1,0,0,0,0);
setLine(1,0,1,0,1);
setLine(1,0,1,0,0);
setLine(0,1,0,0,0);
setLine(0,0,0,0,0);	
}

void writeAPO()
{
setLine(1,1,0,0,0);
setLine(0,0,0,0,0);	
}

void writeEMP()
{
setLine(0,0,0,0,0);
setLine(0,0,0,0,0);
setLine(0,0,0,0,0);
setLine(0,0,0,0,0);
}

void writeEM()
{
setLine(1,1,1,0,1);
setLine(0,0,0,0,0);
}

void writeDOT()
{
setLine(0,0,0,0,1);
setLine(0,0,0,0,0);
}

void writeCOM()
{
setLine(0,0,0,1,1);
setLine(0,0,0,0,0);
}

void writeEQL()
{
setLine(0,1,0,1,0);
setLine(0,1,0,1,0);
setLine(0,1,0,1,0);
setLine(0,0,0,0,0);
}

void writeBRKO()
{
setLine(0,1,1,1,0);
setLine(1,0,0,0,1);
setLine(0,0,0,0,0);
}

void writeBRKC()
{
setLine(1,0,0,0,1);
setLine(0,1,1,1,0);
setLine(0,0,0,0,0);
}


void writer(char word[],int size)
{
fill(0x00);
	for (unsigned int i = 0; i < (size+3); i++)
{	
	char current = word[i];
	if (i >= size) current = ' ';
	switch(current)
	{case 'A':
	writeA();
	break;
	case 'B':
	writeB();
	break;
	case 'C':
	writeC();
	break;
	case 'D':
	writeD();
	break;
	case 'E':
	writeE();
	break;
	case 'F':
	writeF();
	break;
	case 'G':
	writeG();
	break;
	case 'H':
	writeH();
	break;
	case 'I':
	writeI();
break;
	case 'J':
	writeJ();
break;
	case 'K':
	writeK();
break;
	case 'L':
	writeL();
break;
	case 'M':
	writeM();
break;
	case 'N':
	writeN();
break;
	case 'O':
	writeO();
break;
	case 'P':
	writeP();
break;
	case 'Q':
	writeQ();
break;
	case 'R':
	writeR();
break;
	case 'S':
	writeS();
break;
	case 'T':
	writeT();
break;
	case 'U':
	writeU();
	break;
	case 'V':
	writeV();
	break;
	case 'W':
	writeW();
	break;
	case 'X':
	writeX();
	break;
	case 'Y':
	writeY();
	break;
	case 'Z':
	writeZ();
	break;
	case '?':
	writeQM();
	break;
	case '\'':
	writeAPO();
	break;
	case '!':
	writeEM();
	break;
	case '(':
	writeBRKO();
	break;
	case ')':
	writeBRKC();
	break;
	case '=':
	writeEQL();
	break;
	case '.':
	writeDOT();
	break;
	case ',':
	writeCOM();
	break;
	default:
	writeEMP();
	break;
	} 
}
}
