TobiasWulf/LED_Cube/Programming in C/History/Nicolas&Grzegorz/starsze/windows.h

/* 
   windows.h

   Include this file if you wish to use the Windows32 API Library

   Copyright (C) 1996 Free Software Foundation

   Author:  Scott Christley <scottc@net-community.com>
   Date: 1996
   
   This file is part of the Windows32 API Library.

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
   If you are interested in a warranty or support for this source code,
   contact Scott Christley <scottc@net-community.com> for more information.
   
   You should have received a copy of the GNU Library General Public
   License along with this library; see the file COPYING.LIB.
   If not, write to the Free Software Foundation, 
   59 Temple Place - Suite 330, Boston, MA 02111-1307, USA.
*/ 

#ifndef _GNU_H_WINDOWS_H
#define _GNU_H_WINDOWS_H

#ifndef RC_INVOKED
#include <limits.h>
#include <stdarg.h>
#endif

/* Base definitions */
#include <base.h>

/* WIN32 messages */
#ifndef WIN32_LEAN_AND_MEAN
#include <messages.h>
#endif

/* WIN32 definitions */
#include <defines.h>

#ifndef RC_INVOKED

/* WIN32 structures */
#include <structs.h>

/* WIN32 functions */
#ifndef WIN32_LEAN_AND_MEAN
#include <funcs.h>
#endif

/* WIN32 PE file format */
#include <pe.h>

#endif /* ! defined (RC_INVOKED) */

/* WIN32 error codes */
#ifndef WIN32_LEAN_AND_MEAN
#include <errors.h>
#endif

#ifndef RC_INVOKED

/* Windows sockets specification version 1.1 */
#ifdef Win32_Winsock
#ifndef WIN32_LEAN_AND_MEAN
#include <sockets.h>
#endif
#endif

/* There is a conflict with BOOL between Objective-C and Win32,
   so the Windows32 API Library defines and uses WINBOOL.
   However, if we are not using Objective-C then define the normal
   windows BOOL so Win32 programs compile normally.  If you are
   using Objective-C then you must use WINBOOL for Win32 operations.
*/
#ifndef __OBJC__
//typedef WINBOOL BOOL;
#endif /* !__OBJC__ */

/* How do we get the VM page size on NT? */
#ifndef vm_page_size
#define vm_page_size 4096
#endif

#endif /* ! defined (RC_INVOKED) */

#endif /* _GNU_H_WINDOWS_H */
